Erik-k/NameBlocks/README.md

# NameBlocks
Small square boards which can be dynamically re-arranged to display a name in any arrangement
