Erik-k/NameBlocks/NameBlocksSchematic.pdf

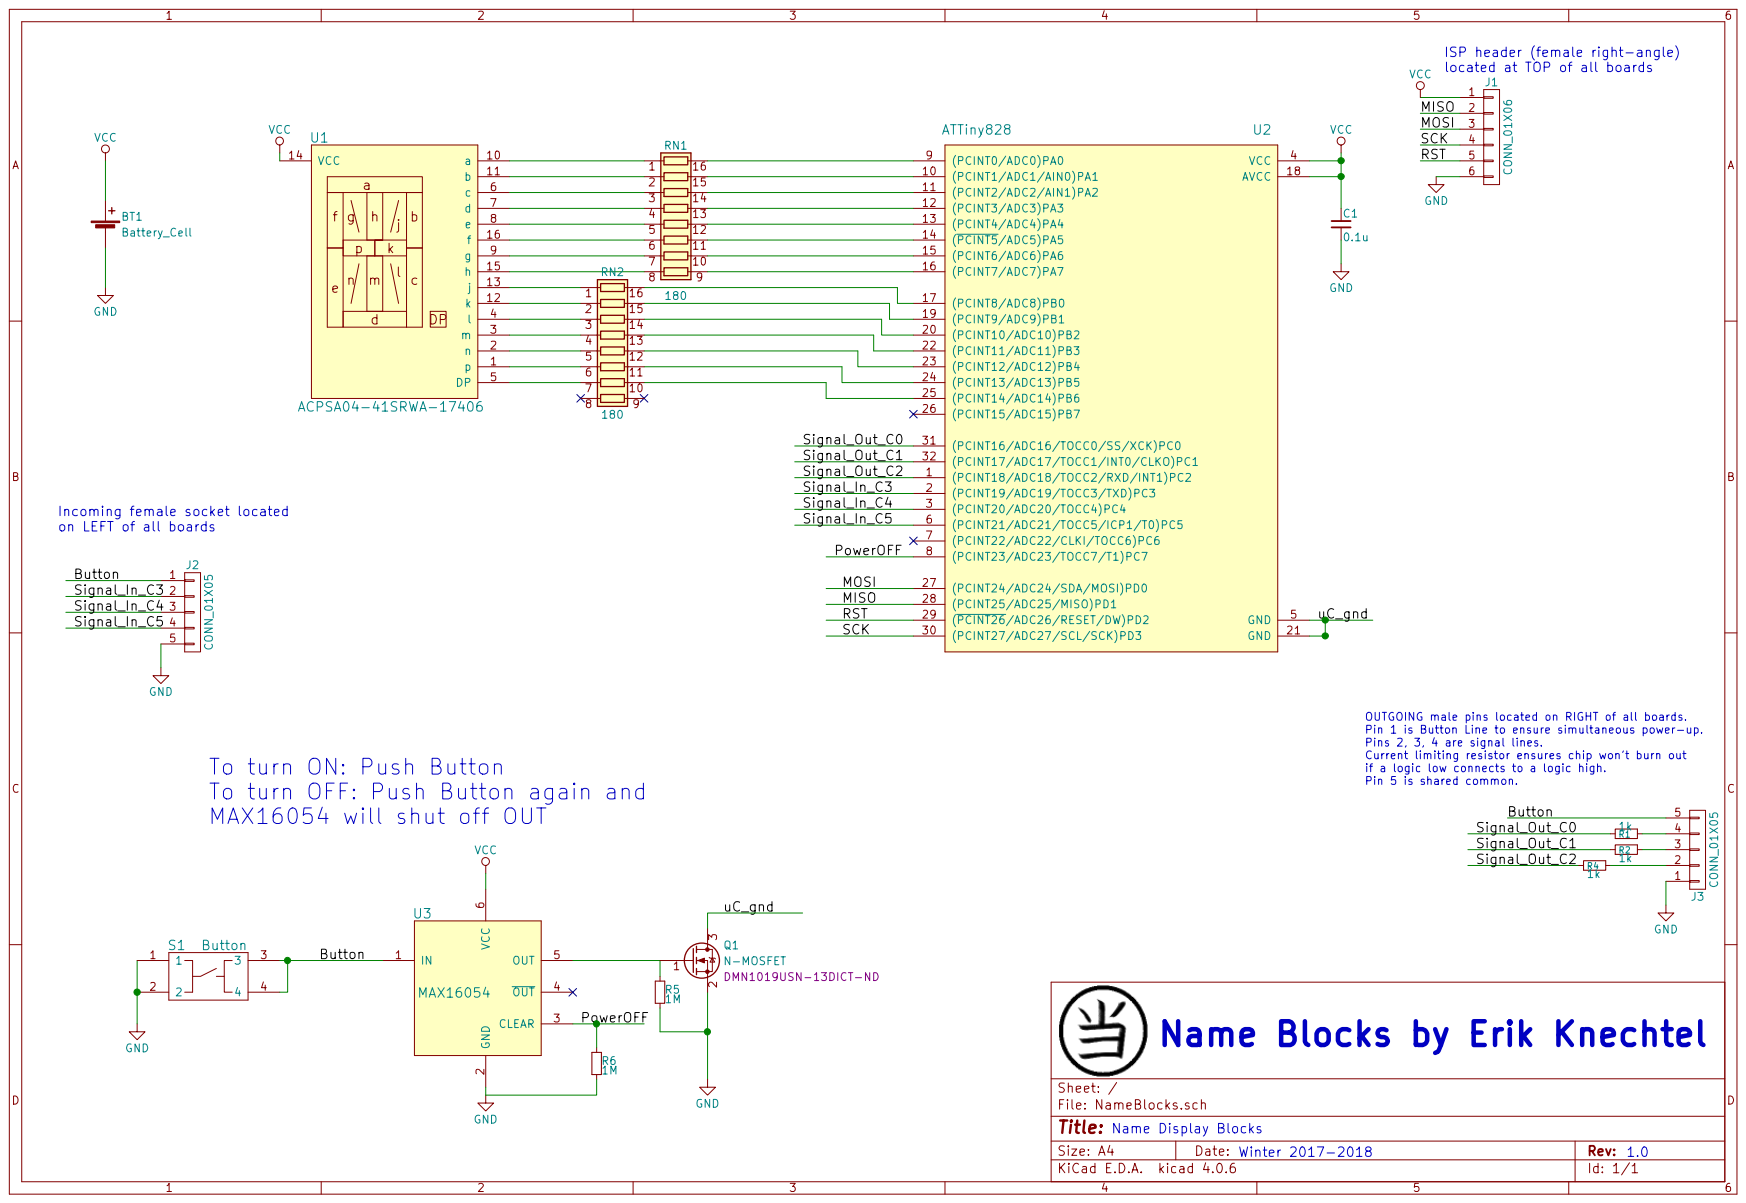
[picture p1: page 1]
