Erik-k/NameBlocks/Hardware/NameBlocks.kicad_pcb

## KiCad design Hardware/NameBlocks.kicad_pcb (2018-03-20)

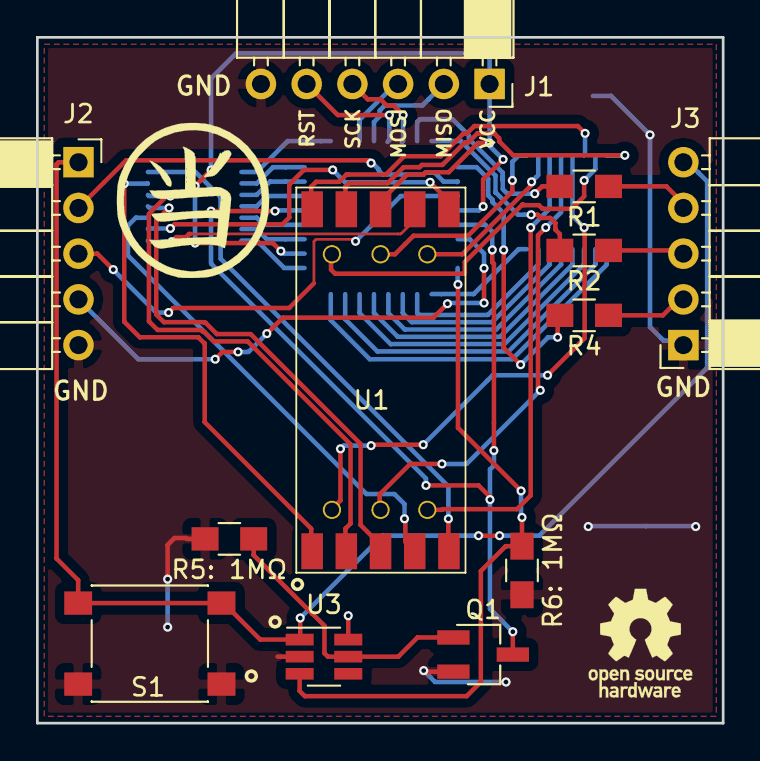
[picture p2: board NameBlocks.kicad_pcb from above]

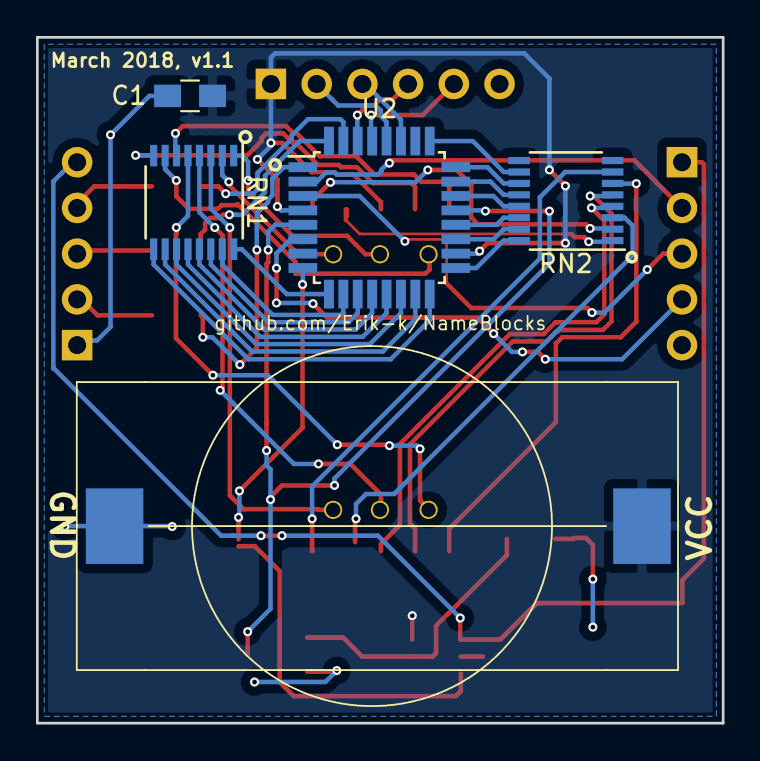
[picture p3: board NameBlocks.kicad_pcb from below]

Board: 2 copper layers, 38.1 x 38.1 mm, 17 parts (5 on the bottom side), 49 nets.

Parts:
BT1: Battery_Cell; CR2032_SMD_BatteryHolder_BU2032SM-BT-GTR
C1: 0.1u; C_0805_HandSoldering
J1: CONN_01X06; Socket_Strip_Angled_1x06_Pitch2.54mm
J2, J3: CONN_01X05; Socket_Strip_Angled_1x05_Pitch2.54mm
Q1: Q_NMOS_GSD; SC-59_Handsoldering
R1, R2, R4: 1k; R_0805_HandSoldering
R5: 1MΩ, R6: 1MΩ: 1M; R_0805_HandSoldering
RN1, RN2: 180; SSOP-16_3.9x4.9mm_Pitch0.635mm
S1: Button; SW_SPST_PTS645
U1: ACPSA04-41SRWA-17406; ACPSA04_Alphanumeric_LED
U2: ATTiny828; TQFP-32_7x7mm_Pitch0.8mm
U3: MAX16054; SOT-23-6_Handsoldering

Connections:
/Button: J2.1, J3.5, S1.3, S1.4, U3.1
/MISO: J1.2, U2.28
/MOSI: J1.3, U2.27
/PowerOFF: R6: 1MΩ.1, U2.8, U3.3
/RST: J1.5, U2.29
/SCK: J1.4, U2.30
/Signal_In_C3: J2.2, U2.2
/Signal_In_C4: J2.3, U2.3
/Signal_In_C5: J2.4, U2.6
/Signal_Out_C0: R1.2, U2.31
/Signal_Out_C1: R2.2, U2.32
/Signal_Out_C2: R4.2, U2.1
/uC_gnd: Q1.3, U2.5, U2.21
GND: BT1.2, C1.2, J1.6, J2.5, J3.1, Q1.2, R5: 1MΩ.2, R6: 1MΩ.2, S1.1, S1.2, U3.2
unnamed: J3.2, R4.1
unnamed: J3.3, R2.1
unnamed: J3.4, R1.1
unnamed: Q1.1, R5: 1MΩ.1, U3.5
unnamed: RN1.1, U1.10
unnamed: RN1.2, U1.11
unnamed: RN1.3, U1.6
unnamed: RN1.4, U1.7
unnamed: RN1.5, U1.8
unnamed: RN1.6, U1.16
unnamed: RN1.7, U1.9
unnamed: RN1.8, U1.15
unnamed: RN1.9, U2.16
unnamed: RN1.10, U2.15
unnamed: RN1.11, U2.14
unnamed: RN1.12, U2.13
unnamed: RN1.13, U2.12
unnamed: RN1.14, U2.11
unnamed: RN1.15, U2.10
unnamed: RN1.16, U2.9
unnamed: RN2.1, U1.13
unnamed: RN2.2, U1.12
unnamed: RN2.3, U1.4
unnamed: RN2.4, U1.3
unnamed: RN2.5, U1.2
unnamed: RN2.6, U1.1
unnamed: RN2.7, U1.5
unnamed: RN2.10, U2.25
unnamed: RN2.11, U2.24
unnamed: RN2.12, U2.23
unnamed: RN2.13, U2.22
unnamed: RN2.14, U2.20
unnamed: RN2.15, U2.19
unnamed: RN2.16, U2.17
VCC: BT1.1, C1.1, J1.1, U1.14, U2.4, U2.18, U3.6
