Erik-k/NameBlocks/(commit log)

2017-11-02 Add files via upload
    First commit. Choosing uC ...
    [NameBlocks.kicad_pcb, NameBlocks.sch]
2017-12-14 Add files via upload
    Created ATTiny828 part in KiCad
    [NameBlocks.kicad_pcb, NameBlocks.sch]
2017-12-19 Created Kingbright symbol, MAX16054 symbol
    [NameBlocks.sch]
2017-12-21 Added 5 pin port, power switch IC
    [NameBlocks.sch]
2018-01-11 Got the stoplight test working for three boards. Gotta remember |= vs &= !
2018-01-18 Finished schematic, all footprints and BOM chosen except switch.
    StopLightTest successful. Software is now going to be on hold until I get boards in.
    [NameBlocks.sch]
2018-01-21 Finished all footprints. Time for layout!
    And I double checked the LED display footprint. Miraculous!
    [NameBlocks.kicad_pcb, NameBlocks.sch]
2018-01-21 Added button.lib
2018-01-31 Started layout. What a mess!
    [NameBlocks.kicad_pcb, NameBlocks.sch]
2018-02-01 Layout finished, but need silkscreen. Going to ask about mfg-ability
    [NameBlocks.kicad_pcb]
2018-02-20 Silkscreen done, ready for order
    [NameBlocks.kicad_pcb]
2018-02-21 Added dimension drawings
    [NameBlocks.kicad_pcb]
2018-02-21 Added MOSFET info to schematic, produced BOM
    [NameBlocks_BOM.csv]
2018-03-05 Added silkscreen for JTAG programming pins
    [NameBlocks.kicad_pcb]
2018-03-20 Shrank trace on Net-(RN2-Pad1) for pin 13 of display
    Pins 13, 14, 15, 16 on the LED segment shorted together on two boards AFTER soldering the display down. I believe that is because trace Net-(RN2-Pad1) from pin 13 on the alphanumeric display was too close to pins 14, 15, 16, resulting in a short after soldering and when the display is pressed down. I changed that trace to 6 mils (from 10 mils) and moved it away from the problem zone.
    [NameBlocks.kicad_pcb]
2018-03-20 Duplicate file
    [NameBlocks.kicad_pcb]
2018-03-20 Added note to fix TSSOP footprints
    [NameBlocks.kicad_pcb]
2018-03-20 Added note in layout to update TSSOP footprints
    [NameBlocks.sch, NameBlocks_BOM.csv]
